cyx3705/2026-007/README.md

# 三维坐标机器（直角坐标机器人）

> 基于 STC8 嵌入式控制的三轴直角坐标机器人课程设计项目，涵盖机械结构、Altium 硬件电路、纯嵌入式/串口联调程序及 WinForms 前端曲线轨迹规划。

## 目录结构

- `b-Altium-Designer/` — Altium 原理图与 PCB 工程（含历史版本 `History/`、ECO 日志）
- `b-Code-三维坐标机器人纯嵌入式代码/` — 纯嵌入式控制程序（按键点动、扫描记录与回放，三轴独立频率 + 梯形加减速）
- `b-Code-51三维坐标控制机器人嵌入式软件/` — 曲线运动嵌入式程序（串口分段频率控制）
- `b-Code-三维坐标机器人前端设计/` — C# WinForms 前端（路径规划、频率换算、串口下发）
- `b-Code-虚拟示波器/` — C# WinForms 小工具，串口采样波形显示，用于调试/测量步进脉冲频率
- `b-Code-51与电脑通讯/`、`b-Code-轴输出方波与上报/` — 串口通信与单轴方波输出相关实验代码
- `b-Code-小灯点亮实验/` — STC8 入门实验（MAX7219 点阵屏图案显示），用于熟悉 Keil/C51 开发流程
- `b-Module-SE/`、`b-Module-2D/` — 三维模型（Solid Edge 装配体/零件）与二维工程图纸（.dwg）
- `b-Office/` — 设计说明书、指导书、任务文档与汇报材料
- `b-Picture/` — 项目图片资源（效果图、前端界面、电路板实物等）
- `b-References/` — 参考资料、元器件手册、驱动与烧录工具
- `Unused/` — 暂未使用/已废弃的辅助资源（EPLAN 电气图、KeyShot 渲染、SolidWorks 备份模型等）

## 使用方法（包括INDEX）

### 项目概览

本项目设计并制作一套**直角坐标机器人 / 直线运动模组**，通过嵌入式微机数字控制实现机械手在 x、y、z 三轴的调节与移动。系统采用龙门式结构：x 轴同步带传动，y、z 轴滚珠丝杠传动，步进电机驱动；控制核心为 **STC8A8K64D4**，支持单轴手动控制、轨迹扫描记录/回放，以及上位机曲线轨迹联调。

**主要技术指标：**

| 项目 | 参数 |
|---|---|
| 运动范围 | 400 mm × 400 mm × 125 mm（x、y、z） |
| 控制方式 | 数字控制，三轴独立运动 |
| 位移分辨率 | ≥ 0.015 mm |
| 重复定位精度 | ± 0.25 mm |
| 有效负荷 | 4 kg |
| 工作速度 | 20 mm/s |

### 效果图

**整机效果：**

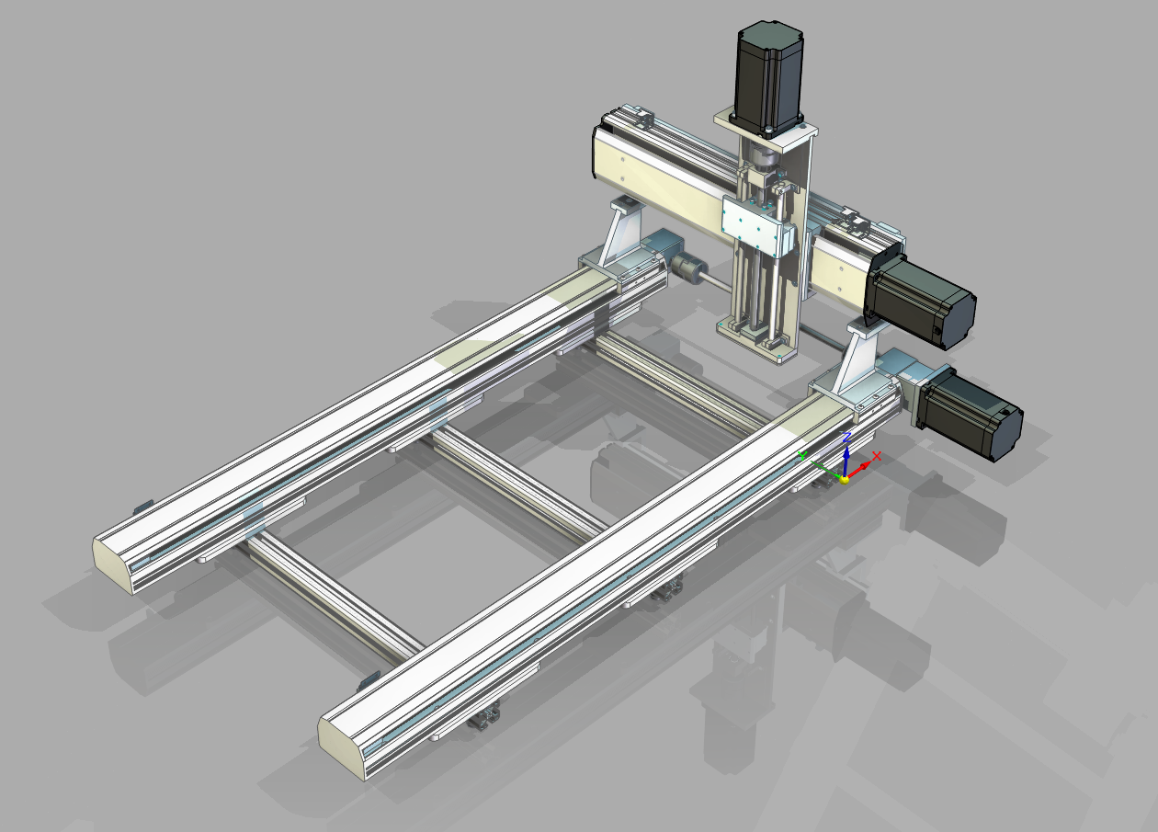
[picture p1: b-Picture/效果图.png]
整机效果图


**前端设计界面（曲线轨迹规划与串口联调）：**

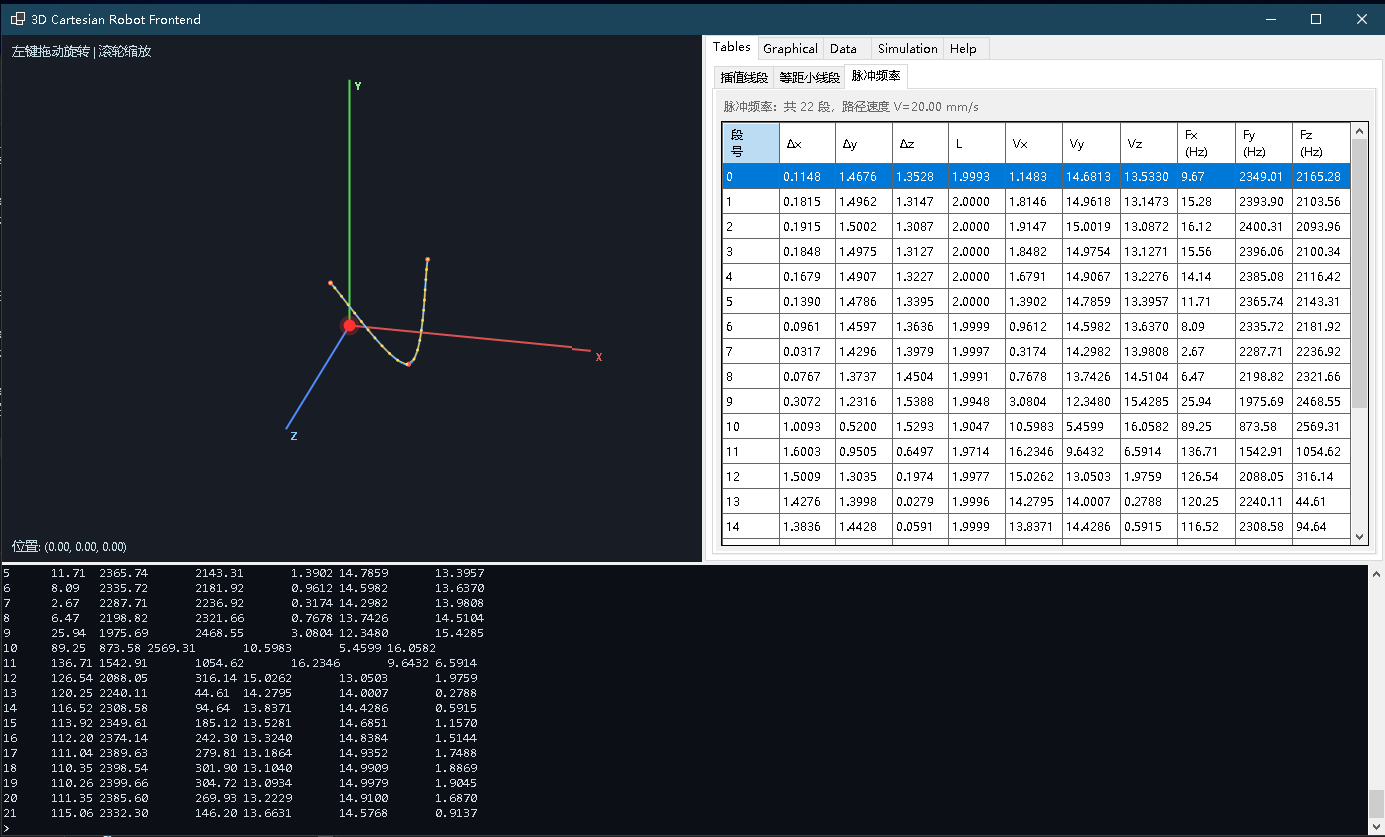
[picture p2: b-Picture/前端设计视图.png]
前端设计视图


**控制板实物：**

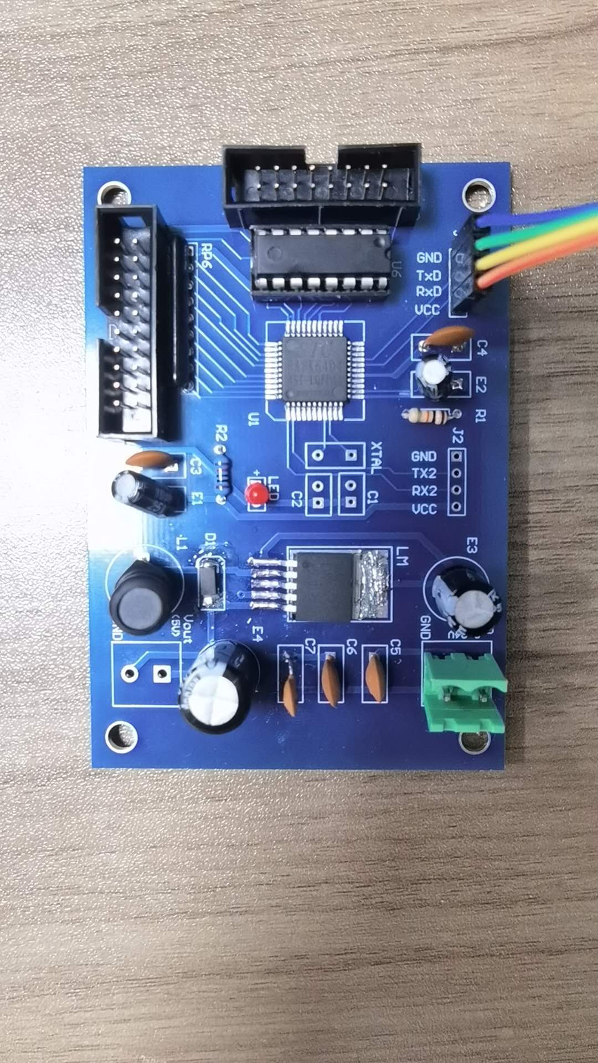
[picture p3: b-Picture/板子实物图.jpg]
板子实物效果图


### 设计说明

#### 机械与电气

- 结构方案见 `b-Module-SE/`，二维图纸见 `b-Module-2D/`
- 硬件电路在 `b-Altium-Designer/` 中完成原理图与 PCB 设计
- 电路说明图片见 `b-Picture/`（原理图、PCB 布局、三维视图）
- 完整设计文档：`b-Office/三维坐标机器控制设计说明书.docx`
- 课程指导书：`b-Office/直角坐标机器人设计与制作指导书（2026年2月修订）.doc`

#### 控制程序（两套固件 + 实验/调试小程序）

| 模式 | 目录 | 说明 |
|---|---|---|
| 纯嵌入式 | `b-Code-三维坐标机器人纯嵌入式代码/` | 不依赖上位机；P0 按键点动，P2 输出三轴 CLK/DIR；支持扫描记录与自动回放；三轴各自独立工作频率并带梯形加减速 |
| 曲线联调 | `b-Code-51三维坐标控制机器人嵌入式软件/` | 串口接收 `Fx,Fy,Fz,DirX,DirY,DirZ###`，Timer0 中断同步输出三轴脉冲 |
| 单轴实验 | `b-Code-轴输出方波与上报/`、`b-Code-51与电脑通讯/` | 单轴方波输出、串口上报调试代码 |
| 入门实验 | `b-Code-小灯点亮实验/` | MAX7219 点阵屏图案显示，STC8/Keil 开发流程练习 |
| 调试工具 | `b-Code-虚拟示波器/` | 串口采集波形并绘图，用于实测/标定步进脉冲频率 |

**引脚定义（步进驱动）：**

- P2.0 / P2.1 — X 轴 CLK / DIR
- P2.2 / P2.3 — Y 轴 CLK / DIR
- P2.4 / P2.5 — Z 轴 CLK / DIR

**三轴脉冲频率与梯形加减速（`b-Code-三维坐标机器人纯嵌入式代码/text1.c`）：**

依据《直角坐标机器人设计与制作指导书（2026年2月修订）》的传动参数计算得到三轴工作频率：

| 轴 | 传动型式 | 导程 | 细分 | 减速比 | 位移分辨率 | 20mm/s 对应频率 |
|----|---|---|---|---|---|---|
| X | 同步带 | 95 mm | 4 | 1:10 | 0.0119 mm | 1680 Hz |
| Y | 滚珠丝杠 | 5 mm | 4 | 1:1 | 0.00625 mm | 3200 Hz |
| Z | 滚珠丝杠 | 5 mm | 4 | 1:1 | 0.00625 mm | 3200 Hz |

固件通过 DDS（相位累加器）分频实现三轴不同频率同时输出（软件延迟时基，非硬件定时器，需示波器标定 `BASE_DELAY_COUNT`），并叠加线性（梯形）加减速：起步于起动频率 500Hz、按 `ACCEL_STEP` 线性升到工作频率、保持匀速、松开/停止后线性降回起动频率再停止。可交互查看单轴 v-t 梯形图：`b-Code-三维坐标机器人纯嵌入式代码/梯形加减速v-t图.html`（浏览器直接打开，红点标注按下/抬起按钮的加减速起点）。

#### 曲线运动流程

1. 在前端添加控制点，选择插值方式（linear / bezier / spline）
2. `PathPlanner` 等距采样，将曲线分解为微小直线段
3. `FrequencyConverter` 按路径速度换算三轴脉冲频率
4. 串口逐段下发至 MCU，嵌入式定时器同步执行

串口协议：`Fx,Fy,Fz,DirX,DirY,DirZ###` → MCU 回复 `OK###`；握手 `PING###` → `PONG###`

### 快速上手

#### 1. 纯嵌入式模式（独立调试）

1. 用 Keil 打开 `b-Code-三维坐标机器人纯嵌入式代码/text1.uvproj`
2. 编译并烧录至 STC8A8K64D4 控制板
3. 上电后通过面板按键进行三轴点动、扫描与回放（详见设计说明书 2.2 节）

#### 2. 曲线联调模式（前端 + 嵌入式）

**下位机：**

1. 打开 `b-Code-51三维坐标控制机器人嵌入式软件/text1.uvproj`，编译烧录
2. 控制板串口默认 **9600 bps**，连接 USB-串口模块

**上位机：**

1. 用 Visual Studio 打开 `b-Code-三维坐标机器人前端设计/` 解决方案
2. 运行主程序：

```bash
cd b-Code-三维坐标机器人前端设计/b-Code-三维坐标机器人前端设计
dotnet run
```

3. 在界面中选择串口、建立连接，添加路径控制点并执行轨迹下发
4. 串口测试模式：`dotnet run -- serial-test`

更详细的前端说明见 `b-Code-三维坐标机器人前端设计/README.md`。

#### 3. 硬件电路查看

- Altium 工程：`b-Altium-Designer/Project.PrjPcb`
- 导出图片：`b-Picture/电路板原理图.png`、`电路PCB图片.png`、`电路板3d视图.png`

### INDEX（关键文件索引）

| 类型 | 路径 |
|---|---|
| 项目总览 | `README.md`（本文件） |
| 控制设计说明书 | `b-Office/三维坐标机器控制设计说明书.docx` |
| 机械设计说明书 | `b-Office/三维坐标机器设计说明书.docx` |
| 课程指导书 | `b-Office/直角坐标机器人设计与制作指导书（2026年2月修订）.doc` |
| 原理图 / PCB | `b-Altium-Designer/SCH.SchDoc`、`PCB.PcbDoc` |
| 纯嵌入式源码 | `b-Code-三维坐标机器人纯嵌入式代码/text1.c` |
| 梯形加减速 v-t 图 | `b-Code-三维坐标机器人纯嵌入式代码/梯形加减速v-t图.html` |
| 曲线嵌入式源码 | `b-Code-51三维坐标控制机器人嵌入式软件/text1.c` |
| 前端主程序 | `b-Code-三维坐标机器人前端设计/b-Code-三维坐标机器人前端设计/Form1.cs` |
| 路径规划 | `b-Code-三维坐标机器人前端设计/b-Code-三维坐标机器人前端设计/PathPlanner.cs` |
| 串口协议 | `b-Code-三维坐标机器人前端设计/b-Code-三维坐标机器人前端设计/SerialProtocol.cs` |
| 项目图片 | `b-Picture/` |

## 保留内容

### logo与作者

- 作者：pinavia
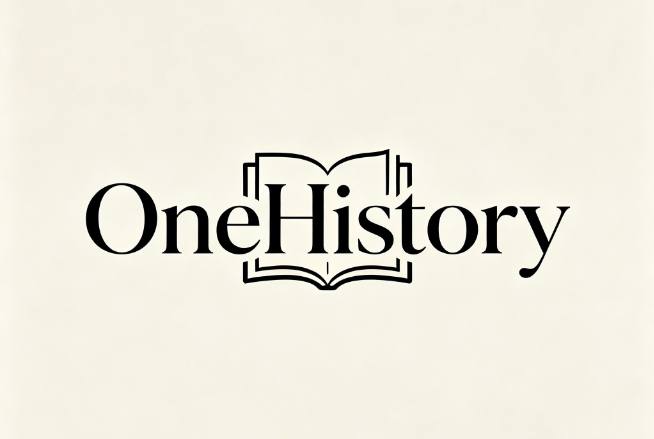
[picture p4: Logo.png]
- 

### 学习许可与权利保留

- 本项目允许个人、学校和研究者进行非商业性的学习、研究和引用。
- 未经著作权人书面许可，不得将项目内容用于商业开发、产品制造、商业服务、商业宣传、投标交付、毕业设计成品交付或再授权。
- 不得删除作者、来源、版本历史和第三方许可证声明，不得将本项目或其衍生成果宣称为与作者无关的原创项目。
- 软件源码适用 [PolyForm Noncommercial 1.0.0](https://polyformproject.org/licenses/noncommercial/1.0.0/)；机械模型、PCB、原理图、图片、文档、Unity 工程和其他非软件资料适用 [CC BY-NC-ND 4.0](https://creativecommons.org/licenses/by-nc-nd/4.0/)。
- SE、SW、STEP/STP 及其他三维模型仅允许个人或学校进行非商业学习、评审和研究；未经著作权人书面许可，不得用于加工、打样、制造、销售、量产、投标、产品交付、商业宣传、改作或再授权。
- 第三方组件、模板、元件库、外购件模型和工具仍受其原始许可证约束；本声明不扩大作者对第三方内容的权利。

商业使用、产品化、公司内部长期使用、转让或排他性授权需另行取得著作权人的书面许可。
