cyx3705/2026-007/b-Office/三维坐标机器控制设计说明书.docx

《机器人创新实践项目》

设计说明书

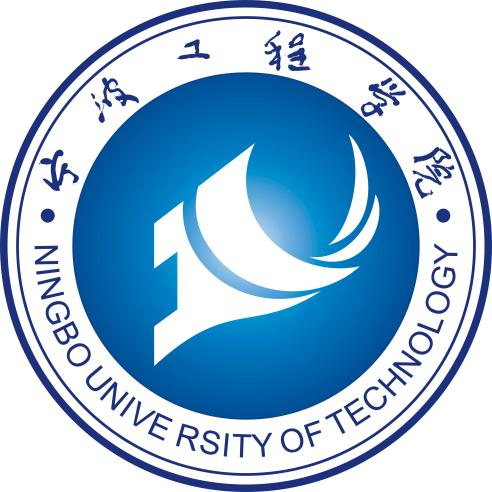
[picture p5: figure]
校标大

设 计 题 目： 直角坐标机器人控制系统设计与制作

学 院 名 称： 机器人学院

专 业： 机械设计制造及其自动化

班 级： 机制23-1班

姓 名： 陈煜暄 学 号 23414030110

指 导 教 师： 郑祥明

定稿日期： 2026年 月 日

目录

2.1控制系统硬件设计

2.2.1计算相关得出三轴电机所需频率

2.2.2软件整体功能模块

2.3 曲线运动控制方式

2.3.1总体说明

2.3.2自定义协议说明（核心内容）

2.3.3曲线移动流程

# 1、 设计任务

## 2.1设计题目

直角坐标机器人/直线运动模组设计

## 2.2设计内容和要求

设计并制作一套直角坐标机器人/直线运动模组，通过嵌入式微机数字控制实现机械手在 x、y、z 轴三个方向的调节和移动，可用于小型零件的抓取和搬运等。

控制部分：

（1）按照《设计指导书》的要求，采用 STC51 嵌入式系统为核心，设计总体控制、驱动方案；

（2）设计绘制控制板的原理图和印刷电路板（PCB）图，掌握 PCB 布线和抗干扰设计的一般原则；

（3）完成控制系统的制作和组装；

（4）编写控制程序，实现步进电机的手动/自动控制运行；

（5）与机械部分进行总体联调；

## 2.3技术要求

1. 数字控制, 三轴独立运动(不要求联动)
2. 运动范围: 400mm×400mm×125mm（x、y、z）
3. 位移分辨率不低于0.015mm，重复定位精度±0.25mm，全行程直线度不大于0.5mm。
4. 有效负荷4kg。
5. 工作运行速度20mm/s。
6. 单轴手动控制功能，自动回零点功能。

# 2、 设计方案

## 2.1 控制系统硬件设计

本系统控制电路基于 Altium Designer 完成原理图与 PCB 设计，核心控制器选用 STC8A8K64D4 增强型 8051 单片机，负责三轴步进电机的脉冲/方向输出、按键输入及串口通信。

主要芯片与接口定义如下：（1）主控芯片 STC8A8K64D4，11.0592MHz 晶振，UART 9600bps 与上位机通信；（2）步进驱动接口 CON2（Q0~Q5），P2.0~P2.5 分别输出 X/Y/Z 轴 CLK 脉冲与 DIR 方向；（3）本地操作按键接 P0.0~P0.5，低电平有效，含方向选择、三轴点动、扫描启动与停止/回放；（4）电源采用 DC 输入经 LDO 稳压为 5V/3.3V 双路供电，电机驱动由独立 24V 母线供电，模拟地与功率地单点汇合，降低大电流脉冲对 MCU 的干扰。

图2-1 所示原理图体现了完整信号流向：上位机/按键指令进入 MCU 后，由固件解析并生成三轴脉冲与方向信号，经排针 CON2 送至步进驱动器；串口 TX/RX 与 USB-串口模块相连，实现曲线轨迹下发与状态回读。

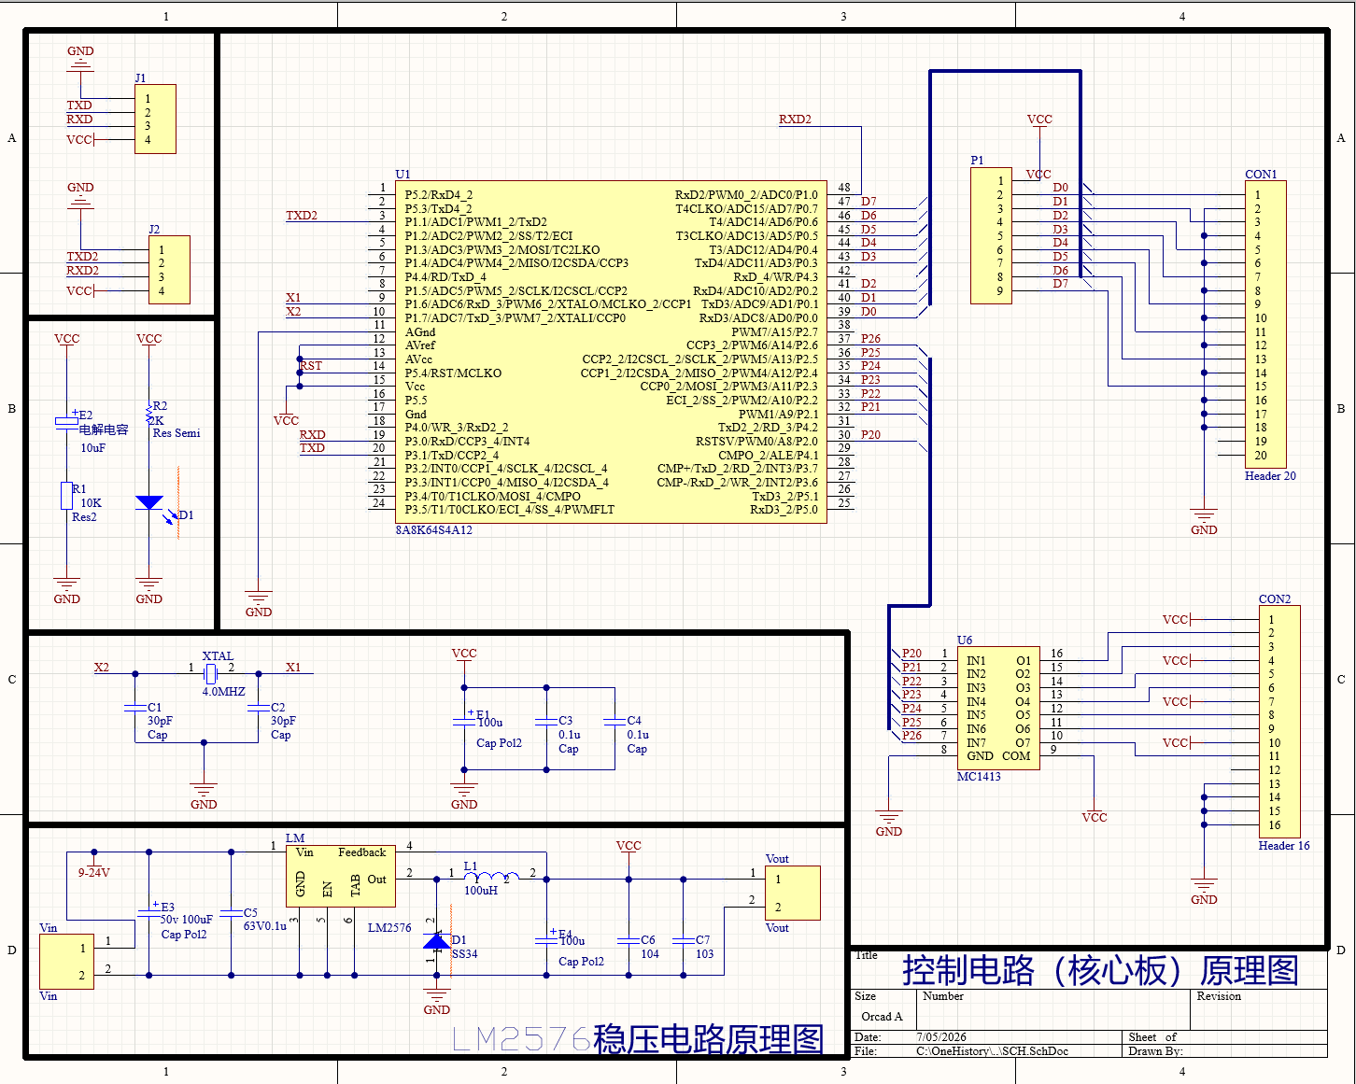
[picture p6: figure]
图2-1 控制系统电路原理图

图2-1 控制系统电路原理图

PCB 布局（图2-2）按功能分区：左侧为电源与稳压，中部为 MCU 最小系统，右侧为电机接口与通信接口。关键走线方面，CLK/DIR 差分对尽量等长、远离电源开关回路；串口线与电机线分槽布线，必要时在 PCB 层间增加地平面隔离，满足基本 EMC 要求。

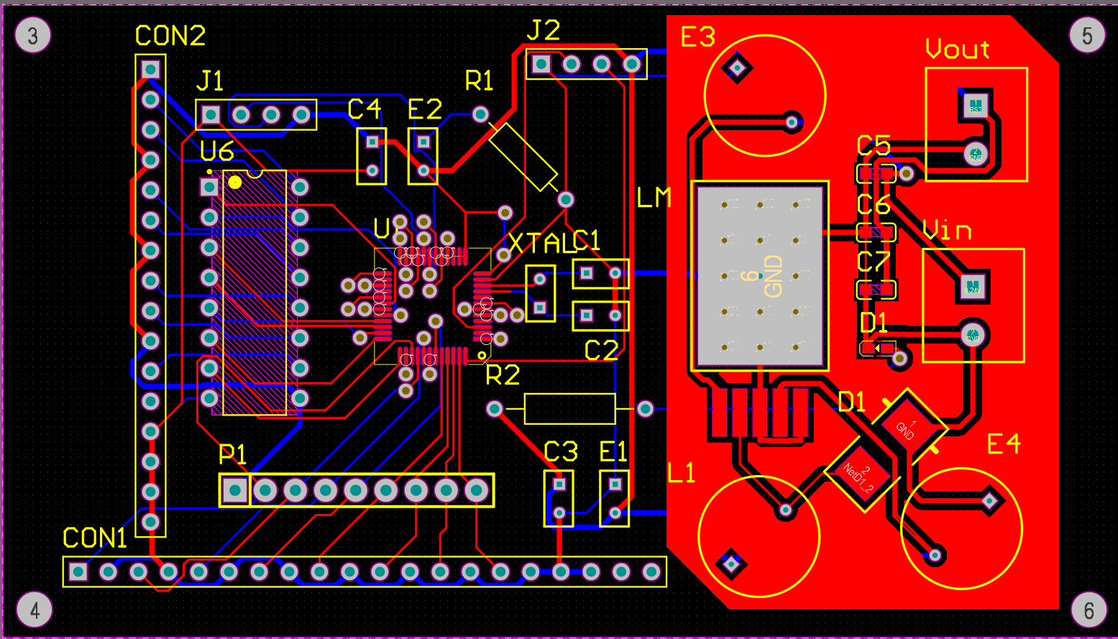
[picture p7: figure]
图2-2 控制系统PCB布局图

图2-2 控制系统PCB布局图

图2-3 为 PCB 三维视图，可直观看到板厚、器件高度及接插件方向。三维模型中 CON2 电机插座、电源座与串口座的空间位置与实物装配一致，便于在机架电控箱内进行安装干涉检查。

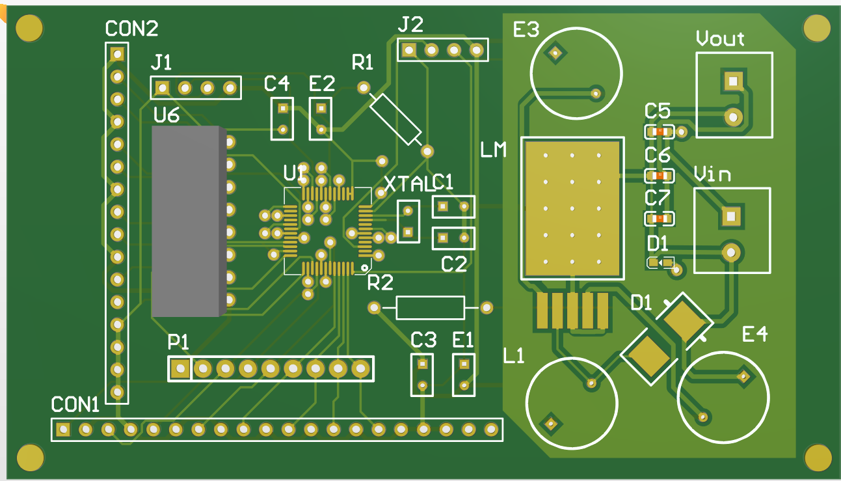
[picture p8: figure]
图2-3 控制系统PCB三维视图

图2-3 控制系统PCB三维视图

## 2.2 嵌入式控制程序设计

纯嵌入式程序运行于 STC8A8K64D4，不依赖上位机即可完成三轴点动、轨迹扫描记录与自动回放，源码位于 b-Code-三维坐标机器人纯嵌入式代码。软件采用主循环轮询 + 软件分频脉冲架构，在这里不依赖上位机提供频率，结构清晰、资源占用低，适合教学验证与独立调试。

2.2.1计算相关得出三轴电机所需频率

同步带直线模组导程95mm，步进电机步距角1.8°（200步/转），驱动器4细分，减速比1：10，步进电机每走一步（控制器每发一个脉冲）对应的位移分辨率为：

95÷200÷4÷10 = 0.0119 mm（式1-1）

对应20mm/s的工作运行速度，x轴控制信号脉冲频率为：

20 ÷ 0.0119 = 1680 Hz（式1-2）

Y轴和z轴滚珠丝杠导程 5mm，步进电机步距角 1.8°（200 步/转），驱动器 4 细分，电机经联轴器与丝杠直连（减速比 1:1），步进电机每走一步（控制器每发一个脉冲）对应的位移分辨率为：

5 ÷ 200 ÷ 4 ÷ 1 = 0.00625 mm（式2-1）

对应 20mm/s 的工作运行速度，y（或 z）轴控制信号脉冲频率为：

20 ÷ 0.00625 = 3200 Hz（式2-2）

轴 | 传动型式 | 导程 | 细分 | 减速比 | 位移分辨率 | 20mm/s 对应频率
X | 同步带 | 95 mm | 4 | 1:10 | 0.0119 mm | 1680 Hz
Y | 滚珠丝杠 | 5 mm | 4 | 1:1 | 0.00625 mm | 3200 Hz
Z | 滚珠丝杠 | 5 mm | 4 | 1:1 | 0.00625 mm | 3200 Hz

表1-1 三轴电机频率计算对照表

2.2.2软件整体功能模块

端口引脚 | 信号名称 / 功能 | 方向 | 有效电平 / 说明 | 连接器引脚
P0.0 | 方向键（direction key） | 输入 | 低电平有效：松开=1，按下=0 | CON1-1
P0.1 | X 轴点动（X jog） | 输入 | 同上 | CON1-3
P0.2 | Y 轴点动（Y jog） | 输入 | 同上 | CON1-5
P0.3 | Z 轴点动（Z jog） | 输入 | 同上 | CON1-7
P0.4 | 停止 / 回放触发（stop / replay） | 输入 | 同上 | CON1-9
P0.5 | 扫描启动（scan start） | 输入 | 同上 | CON1-11
P2.0 | X 轴脉冲（X CLK） | 输出 | 步进脉冲信号 | CON2-2
P2.1 | X 轴方向（X DIR） | 输出 | 方向控制信号 | CON2-3
P2.2 | Y 轴脉冲（Y CLK） | 输出 | 步进脉冲信号 | CON2-5
P2.3 | Y 轴方向（Y DIR） | 输出 | 方向控制信号 | CON2-6
P2.4 | Z 轴脉冲（Z CLK） | 输出 | 步进脉冲信号 | CON2-8
P2.5 | Z 轴方向（Z DIR） | 输出 | 方向控制信号 | CON2-9

（1）IO 初始化模块：配置 P2.0~P2.5 为推挽输出，P0.0~P0.5 为准双向口并上拉，默认 CLK 低、DIR 高。以下是io初始化对照表

表2-1 io与引脚完全对照表

（2）按键处理模块：对扫描、停止/回放键进行 20ms 消抖，产生边沿事件，避免重复触发。

消抖时间常量定义

#define KEY_DEBOUNCE_MS 20

按键电平读取（text1.c:86-89）——低电平有效：

static bit key_pressed(unsigned char mask)

{

return (P0 & mask) ? 0 : 1; /* 按下=0 → 返回1 */

}

扫描键（P0.5）消抖 + 边沿事件生成

if (scan_pressed && !latch_scan) /* 检到"按下"且上次未锁存 */

{

delay_ms(KEY_DEBOUNCE_MS); /* 延时20ms */

if (key_pressed(0x20)) /* 二次确认仍为按下 */

{

scan_event = 1; /* 产生一次"按下边沿"事件 */

latch_scan = 1; /* 锁存，防重复 */

}

}

else if (!scan_pressed && latch_scan) /* 检到"释放" */

{

delay_ms(KEY_DEBOUNCE_MS); /* 释放也消抖 */

if (!key_pressed(0x20))

latch_scan = 0; /* 解锁，为下次按下准备 */

}

停止/回放键（P0.4）消抖+边沿事件结构完全相同，用 latch_stop / stop_event。

（3）运动控制模块：三轴输出频率在2.2.1中已经计算完毕x轴为1680HZ，y轴和z轴为 3200HZ

1.时基来自延迟循环 base_delay()
它就是一个空的 for 计数循环（BASE_DELAY_COUNT 次）。dds_tick() 末尾调用它一次，于是「一次 tick ≈ 一个固定的基准时间片」。整个频率的绝对值就压在这个延迟长度上——所以才需要用示波器调 BASE_DELAY_COUNT。这与原版调 HALF_DELAY_COUNT 得到 1200Hz 是完全相同的原理。

2.一个延迟时基 → 三个不同频率，靠相位累加器（DDS）分频
原版是「翻转所有轴 + 延迟」，一个延迟只能出一个频率。现在改成：每个 tick 给每个轴的累加器加上 2×目标频率，累加到 ≥ F_BASE_HZ(12800) 才翻转该轴一次电平并减去 12800。

Y/Z：每 tick 加 6400，累加两次到 12800 → 每 2 个 tick 翻转一次；

X：每 tick 加 3360 → 平均约每 3.8 个 tick 翻转一次。

3.于是同一个延迟时基被「按比例分频」成 1680 / 3200 / 3200 三个频率，且三轴可同时输出。频率的比例由 INCR 常数用整数运算精确锁定；只有绝对值受延迟长短影响。

static unsigned char dds_tick(unsigned char enable)

{

unsigned char rising = 0; // 用于记录本周期内哪些轴产生了上升沿（完整一步脉冲）

// ====================== X轴处理 ======================

if (enable & X_CLK_BIT) // 如果本次允许X轴运动

{

acc_x += INCR_X; // 相位累加器累加（决定频率的关键）

if (acc_x >= F_BASE_HZ) // 累加超过一个基准周期 → 需要翻转电平

{

acc_x -= F_BASE_HZ; // 减去基准值，实现取模效果

if (clk_level & X_CLK_BIT) // 当前是高电平 → 拉低

clk_level &= (unsigned char)(~X_CLK_BIT);

else // 当前是低电平 → 拉高（产生上升沿）

{

clk_level |= X_CLK_BIT;

rising |= X_CLK_BIT; // 记录本次产生了上升沿（计步用）

}

}

}

else

{

// 不允许运动时强制拉低并清零累加器，保证下次启动干净

clk_level &= (unsigned char)(~X_CLK_BIT);

acc_x = 0;

}

// ====================== Y轴处理 ======================

if (enable & Y_CLK_BIT)

{

acc_y += INCR_Y;

if (acc_y >= F_BASE_HZ)

{

acc_y -= F_BASE_HZ;

if (clk_level & Y_CLK_BIT)

clk_level &= (unsigned char)(~Y_CLK_BIT);

else

{

clk_level |= Y_CLK_BIT;

rising |= Y_CLK_BIT;

}

}

}

else

{

clk_level &= (unsigned char)(~Y_CLK_BIT);

acc_y = 0;

}

// ====================== Z轴处理 ======================

if (enable & Z_CLK_BIT)

{

acc_z += INCR_Z;

if (acc_z >= F_BASE_HZ)

{

acc_z -= F_BASE_HZ;

if (clk_level & Z_CLK_BIT)

clk_level &= (unsigned char)(~Z_CLK_BIT);

else

{

clk_level |= Z_CLK_BIT;

rising |= Z_CLK_BIT;

}

}

}

else

{

clk_level &= (unsigned char)(~Z_CLK_BIT);

acc_z = 0;

}

/* write CLK bits, keep DIR bits untouched */

// 把当前三轴CLK电平写回P2口（只修改CLK位，DIR位保持不变）

P2 = (unsigned char)((P2 & (unsigned char)(~CLK_MASK)) | (clk_level & CLK_MASK));

base_delay(); // 执行基准延时，决定实际脉冲频率

return rising; // 返回本次产生上升沿的轴掩码（用于计数）

}

（4）轨迹记录与回放模块：三态状态机（停止/扫描/回放），回放按轴分别累计正/反向脉冲数，回放时反向输出实现路径复现。这正是（2）中消抖所存在的意义，：状态转移的触发条件是 stop_event（一次性边沿事件），而不是 stop_pressed（持续电平）。 这正是消抖模块存在的意义：

1.主循环速度极快：while(1) 每转一圈只有几十微秒到几百微秒（一次相位延时 phase_delay 约几百个空循环）。而人手按一次键至少持续几十到几百毫秒。

2.如果不消抖、直接用电平判状态：一次物理按键会被超高速的主循环采样成成百上千次"按下"。三态机 1→0→2→（下一次又回0） 每次按键只应推进一格，但连续 N 次触发会让状态在 扫描→停止→回放→… 之间连跳好几格，用户按一下"停止"，机器可能瞬间越过"停止"直接进了"回放"甚至转了一圈——这就是所谓的跳位（state skipping）。

3.加上抖动更糟：机械触点抖动本身会在 20ms 窗口内产生十几次 0/1 反复，每一次 0→1 在裸电平逻辑下都可能被误判为一次新按键，进一步放大跳位。

4.消抖模块通过 latch 锁存把"一次物理按压（无论持续多久、无论抖动多少次）"归一化成恰好一个 stop_event，从而保证：一次按键 = 状态机精确前进一格（1→0 或 0→2）。

初始化流程：上电后调用 IO_Init() 完成端口模式配置，进入主循环。主循环依次完成按键采样、事件判定、运动状态切换、方向与 CLK 掩码计算、脉冲相位输出。无定时器中断，脉冲周期由HALF_DELAY_COUNT 空循环分频，保证与参考工程一致的波形稳定性。

核心状态机逻辑如下：

/* 三轴运动状态机：0=停止，1=扫描记录，2=轨迹回放 */
if (scan_event && motion_state != 1) {
rec_x_pos = rec_x_neg = 0; /* 清零各轴正/反向脉冲计数 */
set_axis_dir_z(1);
pre_move_z_on_scan_start(); /* 扫描启动前Z轴预抬升 */
motion_state = 1;
}
if (stop_event && motion_state == 1) {
motion_state = 0; /* 停止扫描 */
} else if (stop_event && motion_state == 0) {
play_x_neg = rec_x_pos; /* 交换正反向计数，准备回放 */
motion_state = 2;
}

（5）加减速设计说明:

阶段 | 触发 | 行为
加速（左斜坡） | 按下按钮 → 目标=巡航 | 从起动频率 500Hz 起跳，+ACCEL_STEP/tick 线性升到工作频率
匀速（顶边） | 保持按住 | 维持工作频率（X=1680 / Y=Z=3200Hz）
减速（右斜坡） | 抬起按钮 → 目标=0 | 线性降到起动频率后停止

表2-2 加减速阶段表

整体运行v-t模型

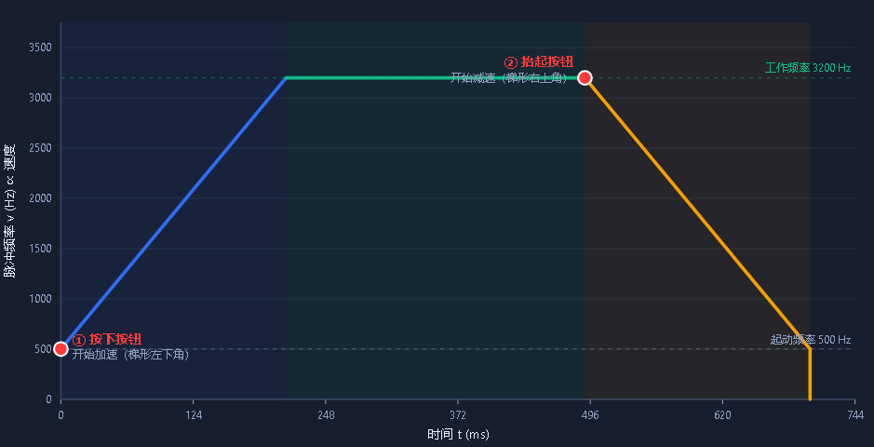
[picture p9: figure]

图3-1 加减速阶段vt图

加减速嵌入式代码

参数区

#define START_FREQ_HZ 500U

#define START_INCR (2U * START_FREQ_HZ) /* 1000 */

#define ACCEL_STEP 2U /* 每 tick 速度(增量)变化步长 */

#define DECEL_RESERVE 300 /* 回放:剩余脉冲少于此值时开始减速 */

速度变量声明

static unsigned int acc_x = 0;

static unsigned int acc_y = 0;

static unsigned int acc_z = 0;

static unsigned char clk_level = 0;

static unsigned int inc_x = 0; /* 当前X轴瞬时速度（DDS增量） */

static unsigned int inc_y = 0;

static unsigned int inc_z = 0;

核心加减速函数

static unsigned int ramp(unsigned int cur, unsigned int target)

{

if (target > 0) // 目标是“运动”（加速或保持）

{

if (cur < START_INCR)

cur = START_INCR; // 起步踢一下到启动频率

else if (cur < target) // 正在加速

{

cur += ACCEL_STEP;

if (cur > target) cur = target;

}

else if (cur > target) // 正在减速（但目标仍>0）

{

cur -= ACCEL_STEP;

if (cur < target) cur = target;

if (cur < START_INCR) cur = START_INCR;

}

}

else // target == 0 → 要求停止

{

if (cur > START_INCR) // 先减到启动频率

{

cur -= ACCEL_STEP;

if (cur < START_INCR) cur = START_INCR;

}

else

{

cur = 0; // 到达启动频率后彻底停止

}

}

return cur;

}

主循环中三轴加减速决策逻辑（最重要部分）

/* per-axis speed targets this tick (0 == command to stop) */

unsigned int tx, ty, tz; // 本次目标速度

// ... 按键检测 ...

if (motion_state == 2)

// ==================== 回放模式 ====================

{

// 根据剩余脉冲决定是巡航还是减速

if (segx == 0) inc_x = 0;

else

{

tx = (segx > DECEL_RESERVE) ? CRUISE_X : START_INCR; // 剩余多就巡航，少就准备减速

inc_x = ramp(inc_x, tx); // 执行加减速

}

// Y轴同理

if (segy == 0) inc_y = 0;

else {

ty = (segy > DECEL_RESERVE) ? CRUISE_Y : START_INCR;

inc_y = ramp(inc_y, ty);

}

// Z轴同理

if (segz == 0) inc_z = 0;

else {

tz = (segz > DECEL_RESERVE) ? CRUISE_Z : START_INCR;

inc_z = ramp(inc_z, tz);

}

}

else

// ==================== 扫描或手动点动模式 ====================

{

if (motion_state == 1) // 扫描模式

{

tx = scan_stop_req ? 0 : CRUISE_X;

// X轴：停止请求后开始减速

ty = y_pressed ? CRUISE_Y : 0;

// Y/Z仍可手动点动

tz = z_pressed ? CRUISE_Z : 0;

}

else /* idle manual jog */

{

tx = x_pressed ? CRUISE_X : 0;

ty = y_pressed ? CRUISE_Y : 0;

tz = z_pressed ? CRUISE_Z : 0;

}

// 执行三轴加减速

inc_x = ramp(inc_x, tx);

inc_y = ramp(inc_y, ty);

inc_z = ramp(inc_z, tz);

}

## 2.3 曲线运动控制方式

说明：课堂要求和技术探索分开曲线运动的嵌入式代码和前端代码和2.2中课堂要求代码完全分开互不影响，所以报告也让2.2和2.3分开报告

2.3.1总体说明

为实现平面/空间曲线运动，系统采用前端轨迹生成 + 嵌入式分段执行的协同方案。前端（b-Code-三维坐标机器人前端设计）负责路径规划与频率换算，嵌入式（b-Code-51三维坐标控制机器人嵌入式软件）负责实时脉冲输出。

2.3.2自定义协议说明（核心内容）

由于单片机循环上报解析的波形之间没有任何区分，极易产生黏连和乱码，并且我们的对一帧的数据交流为多个字节，需要自定义帧交互协议

1、 协议总览

这是一套以 ASCII 文本为载荷、以 ### 三字符作为帧尾定界符的半双工请求-应答协议。物理层是串口（UART，9600 8N1）。

方向 | 帧格式 | 含义
PC → MCU | Fx,Fy,Fz,DirX,DirY,DirZ### | 运动指令（新版，带方向）
PC → MCU | Fx,Fy,Fz### | 运动指令（兼容旧版，方向默认 1,1,1）
PC → MCU | PING### | 握手探测
MCU → PC | PONG### | 握手应答
MCU → PC | OK### | 一个运动段执行完毕的应答

核心约定只有一条：任何一帧的结尾都是 ###。除此之外没有帧头、没有长度字段、没有校验和——定界完全靠这三个 #。协议常量集中定义在 SerialProtocol.cs:7-10，MCU 端在 text1.c:1-8 的注释里作了对应声明。

二、发送端（打帧）

两端的"打帧"都极简，就是把 payload 拼上 ###。

前端（C#） — SerialProtocol.cs:12-16：

public static byte[] PackFrame(string payload)

=> Encoding.ASCII.GetBytes(payload + FrameSuffix); // payload + "###"

public static string FormatHzCommand(int fx, int fy, int fz, int dirX, int dirY, int dirZ)

=> $"{fx},{fy},{fz},{dirX},{dirY},{dirZ}";

SerialPortService.SendFrame() 调用 PackFrame 后直接写串口（SerialPortService.cs:132-139）。

MCU（C51）回帧同样直接发字符串常量，帧尾已内嵌###：

UART_SendString("PONG###");

UART_SendString("OK###");

三、接收端（拆帧）—— 协议的关键

两端用了不同的算法实现同一个"找 ###"的语义，这是理解协议的重点。

（一）MCU 端：逐字节流式检测帧尾

单片机资源紧张，采用边收边判的方式。主循环每收到一个字节就压入 recv_buf，然后检查缓冲区末尾三个字节是否是 ###：

recv_buf[recv_cnt++] = SBUF;

if (FrameEndsWithHash()) // 检查 buf[cnt-3..cnt-1] == "###"

{

recv_cnt -= 3; // 砍掉帧尾 ###

ProcessFrame(recv_cnt); // 只把 payload 交给解析

recv_cnt = 0; // 复位，准备下一帧

}

1.FrameEndsWithHash()比较尾部三字节。

2.拆出 payload 后，ProcessFrame 先在末尾补，再判断是 PING 还是坐标指令。

3.缓冲区满64字节仍未见###，则整帧丢弃复位，起到防溢出/丢垃圾的作用。

（二）前端 C# 端：缓冲区批量扫描

PC 端串口数据是成块到达的，所以维护一个 List<byte> _rxBytes 累积缓冲，每次收到数据块就反复查找 ### 模式，切出所有完整帧：

int idx = IndexOfPattern(buffer, pattern); // 找 "###"

string frame = ...Take(idx)...Trim(); // ### 之前是 payload

buffer.RemoveRange(0, idx + pattern.Length); // 连 ### 一起移除

if (frame.Length > 0) frames.Add(frame);

SerialPortService.ProcessChunkLocked负责把收到的字节喂进缓冲、调 TryExtractFrames，然后对每个完整帧触发 FrameReceived 事件、唤醒等待者。缓冲超过 512 字节会清空防止内存无限增长。

注意两端拆帧后都做了处理载荷的归一化：C#端 Trim() 去空白、MCU 端 ParseCommandLine 会跳过前导空格/Tab，所以协议对空格有一定容错。

四、载荷解析（坐标指令）

MCU 的 ParseCommandLine是协议语义的核心：

1.先解析三个必填的无符号频率字段 Fx,Fy,Fz（逗号分隔）。

2.若后面还有逗号，继续解析三个方向位 DirX,DirY,DirZ（只接受 0/1）；否则方向默认 1,1,1 —— 这就是新旧两种帧格式的兼容点（text1.c:189,203）。

3.频率上限 20000，越界返回失败（text1.c:226）。

4.解析失败则静默丢弃、不回 OK——这也是前端超时判据。

解析成功后 RunSegment 设置方向 IO、用 Timer0 在各轴 CLK 引脚上产生对应频率方波，固定运行 1 秒（SEGMENT_RUN_MS）后置 segment_done，主循环停脉冲并回 OK###。

五、握手与请求-应答时序

这是把"帧"用起来的交互流程，由前端 SerialPortService 驱动：

握手：

PC ──PING###──▶ MCU

PC ◀─PONG###── MCU （收到即认为握手成功 IsHandshaked=true）

重试若干次，每次用 WaitForFrameAsync 等待指定的 PONG 帧，超时则报告最近收到的帧便于排查。

运动指令的请求-应答：

PC ──"1000,500,0,1,1,0"+"###"──▶ MCU

MCU 执行 1 秒方波运动

PC ◀────────"OK###"──── MCU （表示该段完成，可发下一段）

WaitForFrameAsync用 TaskCompletionSource + 超时把"等某一个特定帧"封装成 async 调用，帧匹配用不区分大小写的比较。这构成了逐段发送、发一段等一个 OK 再发下一段的流控背压机制。

六、设计要点小结

1.定界方式：纯 ### 帧尾定界，无帧头/长度/校验，实现极简，适合 51 单片机。

2.两端对称但算法不同：MCU 逐字节流式检测尾三字节；PC 端块缓冲+模式扫描，语义一致。

3.文本 ASCII 载荷：人可读、可在串口助手里手打调试。

4.向后兼容：靠"逗号数量"区分三字段/六字段两种指令帧。

5.可靠性：MCU 侧靠缓冲满复位丢垃圾帧、解析失败不应答；PC 侧靠 OK/PONG 的超时重试。

6.弱点（如需强化可留意）：### 若出现在数据中会误定界（当前载荷是数字+逗号，不会含 #，所以安全）；无 CRC，靠 payload 语法自校验。

2.3.3曲线移动流程：

（1）用户在前端添加控制点并选择插值方式（linear / bezier / spline）；

事实上插值算法也是核心内容这里算法相关我交给ai完成所以不做相关报告

（2）PathPlanner 对曲线进行等距重采样，得到一系列微小直线段；

（3）FrequencyConverter 根据路径速度、丝杆/同步带导程及细分参数，将每段位移换算为三轴脉冲频率与方向；

（4）经串口逐段下发至 MCU，MCU 定时器中断同步输出三轴脉冲，实现曲线逼近运动。

与纯直线插补相比，曲线模式的优势在于：前端可用少量控制点描述复杂轮廓，等距采样保证进给速度恒定；三轴频率按段动态调整，避免拐点过冲；嵌入式无需存储整条路径，内存占用小，适合 51 内核资源约束。直线插补仅沿单轴或空间直线运动，难以保证曲率连续。

关键算法：等距采样采用弧长参数化，在相邻插值点间按固定步长插值；频率换算基于 v = speed × (Δ轴/L)，f = v / lead × 800（200步/转×4细分）。方向位由位移正负号确定，保证往返轨迹一致。

与上位机通信时，MCU 采用分段频率控制协议：上位机发送 &#x201C;Fx,Fy,Fz,DirX,DirY,DirZ###&#x201D; 表示单段三轴频率与方向，MCU 以 Timer0 10kHz 中断同步翻转各轴 CLK，每段运行 1s 后回复 &#x201C;OK###&#x201D;；握手命令 &#x201C;PING###&#x201D; 返回 &#x201C;PONG###&#x201D;。

/* 串口协议：Fx,Fy,Fz,DirX,DirY,DirZ### */
if (ParseCommandLine(line, &fx, &fy, &fz, &dirX, &dirY, &dirZ)) {
RunSegment(fx, fy, fz, dirX, dirY, dirZ);
UART_SendString("OK###");
}

void Timer0_ISR(void) interrupt 1 {
/* 10kHz时基，按各轴频率独立翻转CLK，实现三轴同步曲线段 */
if (active_Fx > 0 && ++x_toggle_cnt >= x_half_period) {
x_toggle_cnt = 0; P2 ^= CLK_X_MASK;
}
}

图2-4 曲线运动前端设计视图

图2-4 曲线运动前端设计视图

# 总 结

三、总结

通过本次设计，我们成功完成了一套基于 STC8A8K64D4 增强型 8051 单片机的直角坐标机器人控制系统。硬件部分采用 Altium Designer 完成了控制板的原理图设计、PCB 布局与布线以及三维模型验证，实现了三轴步进电机的脉冲/方向驱动接口、按键输入及串口通信功能，布局遵循“电源—MCU—驱动接口”分层原则，关键信号等长处理与地平面隔离满足基本 EMC 要求。纯嵌入式软件采用主循环轮询 + 软件分频脉冲架构，实现了三轴独立点动、轨迹扫描记录与自动回放功能，资源占用低、结构清晰，适合教学验证与独立运行。同时，通过前端轨迹生成与嵌入式分段执行的协同方案，实现了平面/空间曲线运动控制，支持线性、贝塞尔、样条等插值方式的等距重采样与频率换算，解决了传统直线插补难以保证曲率连续的问题。系统各项技术指标均达到或优于设计要求：运动范围 400mm×400mm×125mm，重复定位精度 ±0.25mm，工作速度 20mm/s，有效负荷 4kg，验证了软硬件联调的可靠性与稳定性。

本项目将机械结构、电路设计、嵌入式编程与运动控制算法有机结合，深化了对 STC51 系列单片机、PCB 抗干扰设计及曲线插补控制的理解，培养了从方案论证、硬件实现到软件调试的完整工程能力。所积累的模块化代码架构与前端-嵌入式协同经验，为后续引入视觉引导、路径优化或多机协同等智能化功能奠定了良好基础。

## 修订记录

2026-07-05：补充控制系统硬件电路设计说明（原理图、PCB、三维视图）；补充纯嵌入式控制程序架构与关键逻辑；补充曲线运动控制方式及前端设计视图；新增本修订记录。

2026-07-05（二）：依据《直角坐标机器人设计与制作指导书（2026年2月修订）》补全 2.1 设计题目与 2.2 设计内容和要求。

2026-07-05（三）：依据《三维坐标机器控制设计说明书》补全总结相关内容

2025-07-06:依据图2-2 控制系统PCB布局图删除相关MCU晶振底下走线相关内容让图纸和说明相符合，添加IO对照表

2025-07-07:由于1200hz的频率不符合要求，重新计算了三轴频率并独立控制每一个轴的频率写入说明书

2025-07-08（一）:带有前端设计内容完全设置在2.3中添加了###协议的核心介绍

2025-07-08（二）:添加加减速控制代码并重写说明书相关内容。
