cyx3705/2026-007/b-Office/项目报告.pptx

标题

·

制作人 王小明

Prepared by AIR-Tech@ 7/6/2026 6:24:31 PM

## Slide 2

目录

主要设计安排

设计创新点

主要设计难点

接下来的规划

总结与展望

## Slide 3

主要设计安排

·

介绍有关部分
的分工与安排

Prepared by AIR-Tech@ 7/6/2026 6:24:46 PM

## Slide 4

主要设计安排

## Slide 5

主要设计安排

## Slide 6

主要设计安排

## Slide 7

主要设计安排

## Slide 8

设计创新点

·

介绍几个新
的设计与想法

Prepared by AIR-Tech@ 7/6/2026 6:24:58 PM

## Slide 9

设计创新点

## Slide 10

设计创新点

## Slide 11

设计创新点

## Slide 12

设计创新点

## Slide 13

主要设计难点

·

设计遇到的
不确定和难点

Prepared by AIR-Tech@ 7/6/2026 6:25:10 PM

## Slide 14

主要设计难点

## Slide 15

主要设计难点

## Slide 16

主要设计难点

## Slide 17

主要设计难点

## Slide 18

接下来的规划

·

接下来需要做部分未达到的遗憾

Prepared by AIR-Tech@ 7/6/2026 6:25:22 PM

## Slide 19

接下来的规划

## Slide 20

接下来的规划

## Slide 21

接下来的规划

## Slide 22

接下来的规划

## Slide 23

总结与展望

·

Prepared by AIR-Tech@ 7/6/2026 6:25:34 PM

## Slide 24

总结与展望
