cyx3705/2026-007/b-Code-51三维坐标控制机器人嵌入式软件/接口图.png

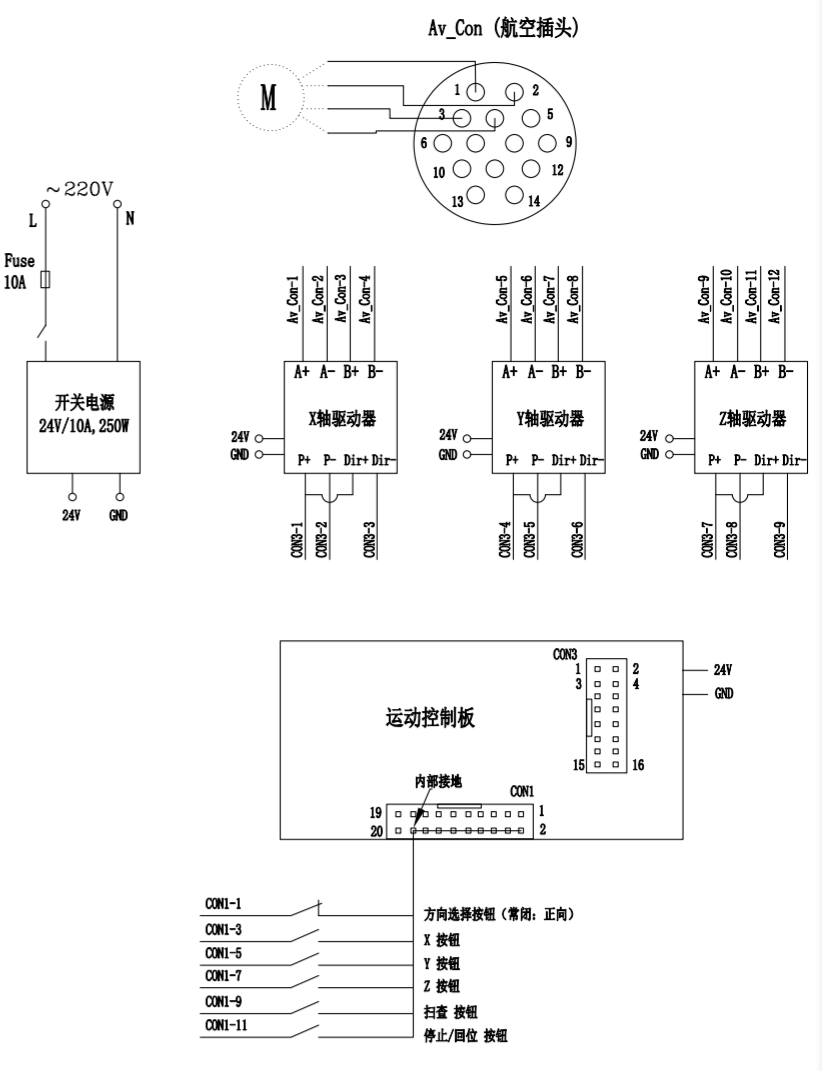
b-Code-51三维坐标控制机器人嵌入式软件/接口图.png
