cyx3705/2026-007/b-References/a-步进电机.png

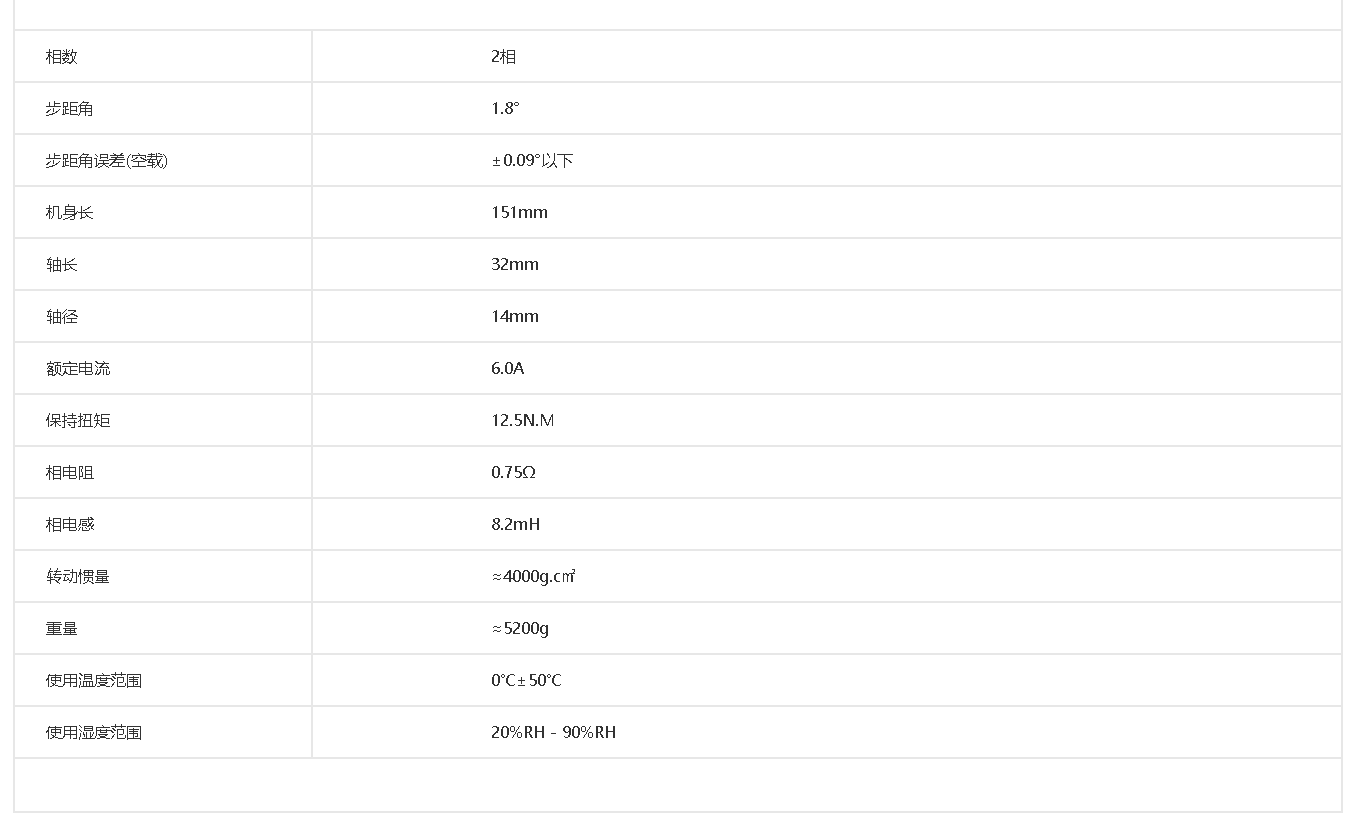
b-References/a-步进电机.png
