cyx3705/2026-007/b-References/b-资料/X轴电机抽头.jpg

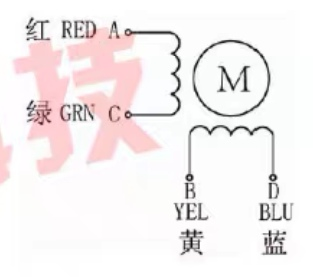
b-References/b-资料/X轴电机抽头.jpg
