cyx3705/2026-007/(list of files, cad)

Other CAD files:
b-Code-51三维坐标控制机器人嵌入式软件/text1.OBJ
b-Code-51与电脑通讯/STARTUP.OBJ
b-Code-三维坐标机器人纯嵌入式代码/text1.OBJ
b-Code-小灯点亮实验/STARTUP.OBJ
b-Code-轴输出方波与上报/STARTUP.OBJ
b-Module-2D/1200-脚垫.dwg
b-References/a-直线模组图纸示例.dwg
b-References/b-资料/面板.dwg
b-Code-51三维坐标控制机器人嵌入式软件/STARTUP.OBJ
b-Code-51与电脑通讯/text1.OBJ
b-Code-三维坐标机器人纯嵌入式代码/STARTUP.OBJ
b-Code-小灯点亮实验/text1.OBJ
b-Code-轴输出方波与上报/text1.OBJ
b-Module-2D/0322-丝杆滑块.dwg
b-References/b-资料/底板.dwg
b-Module-2D/2300-第二轴安装板.dwg
b-Module-2D/XYZ-0112.dwg
b-Module-2D/1231-第一轴同步带安装板.dwg
b-Module-2D/0337-电机安装板.dwg
b-Module-2D/1331-脚钉.dwg
b-Module-2D/2000-第二轴.dwg
b-Module-2D/0338-滑块.dwg
b-Module-2D/1132-轴.dwg
b-Module-2D/1000-第一轴.dwg
b-Module-2D/0332-丝杆.dwg
b-Module-2D/0332-丝杆滑块.dwg
b-Module-2D/033B-滑块保护板.dwg
b-Module-2D/0335-导轨.dwg
b-Module-2D/0300-第三轴.dwg
b-Module-2D/0333-丝杆上板.dwg
b-Module-2D/2332-连接角.dwg
b-Module-2D/0336-导轨连接件.dwg
b-Module-2D/1131-安装板.dwg
b-Module-2D/2231-丝杆安装板.dwg
b-Module-2D/1100-第一轴同步带.dwg
b-Module-2D/1300-脚钉.dwg
b-Module-2D/0334-防护板.dwg
b-Module-2D/033C-丝杆顶板.dwg
b-Module-2D/033A-滑块连接板.dwg
b-Module-2D/2331-安装板零件.dwg
b-Module-2D/0331-丝杆安装板.dwg
b-Module-2D/2200-第二轴丝杆.dwg
b-Module-2D/033A-滑块连接板(1).dwg
