cyx3705/2026-007/(list of files, drawings)

Other design files:
b-Altium-Designer/PCB.PcbDoc
b-Altium-Designer/Project.PrjPcb
b-Altium-Designer/SCH.SchDoc
b-References/b-库文件/8A8K64S4A12.PcbLib
b-References/b-库文件/8A8K64S4A12.SCHLIB
b-References/b-库文件/MyLib.PCBLIB
b-References/b-库文件/MyLib.SCHLIB
