cyx3705/2026-007/(commit log)

2026-05-27 Sync backup - 2026-05-28 00:37
    [0111-LHBT10-S1000-R.cfg, 0112-LHBT10-S1000-R.cfg, 0300-第三轴.cfg, 0300-第三轴.dwg, 0322-丝杆滑块.dwg, 0331-丝杆安装板.dwg, 0332-丝杆.dwg, 0332-丝杆滑块.dwg]
2026-06-23 一键推送更新,将原数字标号统一改为b
    [0111-LHBT10-S1000-R.cfg, 0112-LHBT10-S1000-R.cfg, 0300-第三轴.cfg, 0300-第三轴.dwg, 0322-丝杆滑块.dwg, 0331-丝杆安装板.dwg, 0332-丝杆.dwg, 0332-丝杆滑块.dwg]
2026-07-05 添加报告并基本完成项目
    [8A8K64S4A12.PcbLib, 8A8K64S4A12.SCHLIB, MyLib.PCBLIB, MyLib.SCHLIB, PCB.PcbDoc, SCH.SchDoc, STARTUP.OBJ, text1.OBJ]
2026-07-06 一键推送更新
2026-07-08 重写了三维坐标机器控制设计说明书报告
2026-08-12 一键推送更新 管理规则
2026-08-14 chore: 迁移到 HistoryClio 后的工作区基线
    分仓库迁移遗留在工作区的改动一次性落库，并清理模板带下来的 Unused 脚手架。
    - 删除 Unused/（257 个已入库文件，主要是 b-EPLAN 与占位 READEME）；内容仍可从历史取回。
    - 其余为迁移过程产生的工作区差异，未逐条审阅业务含义。
    本次由 Claude 代为提交，用于把分仓库后的工作树归零。
    [Project.PrjPcb]
2026-09-21 LFS 修复：219 个不足 100MB 的文件转回普通入库（第 1/1 批）
2026-10-10 大扫除：移出资料大文件、清理模板残留、视频压到 1080p
    为改写历史前的黄金水位线。
2026-10-23 README：保留内容对齐模板（logo与作者）
    Claude-Session: https://claude.ai/code/session_01UZ5WhpwWxzS9khp6UQSn2P
